fugalster/Wireless-HVAC-Sensors/board.png

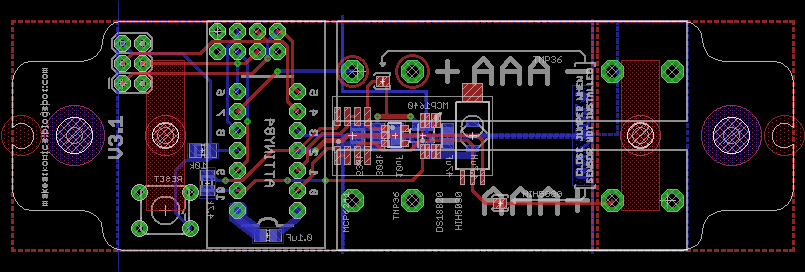
board.png
