fugalster/Wireless-HVAC-Sensors/schematic.png

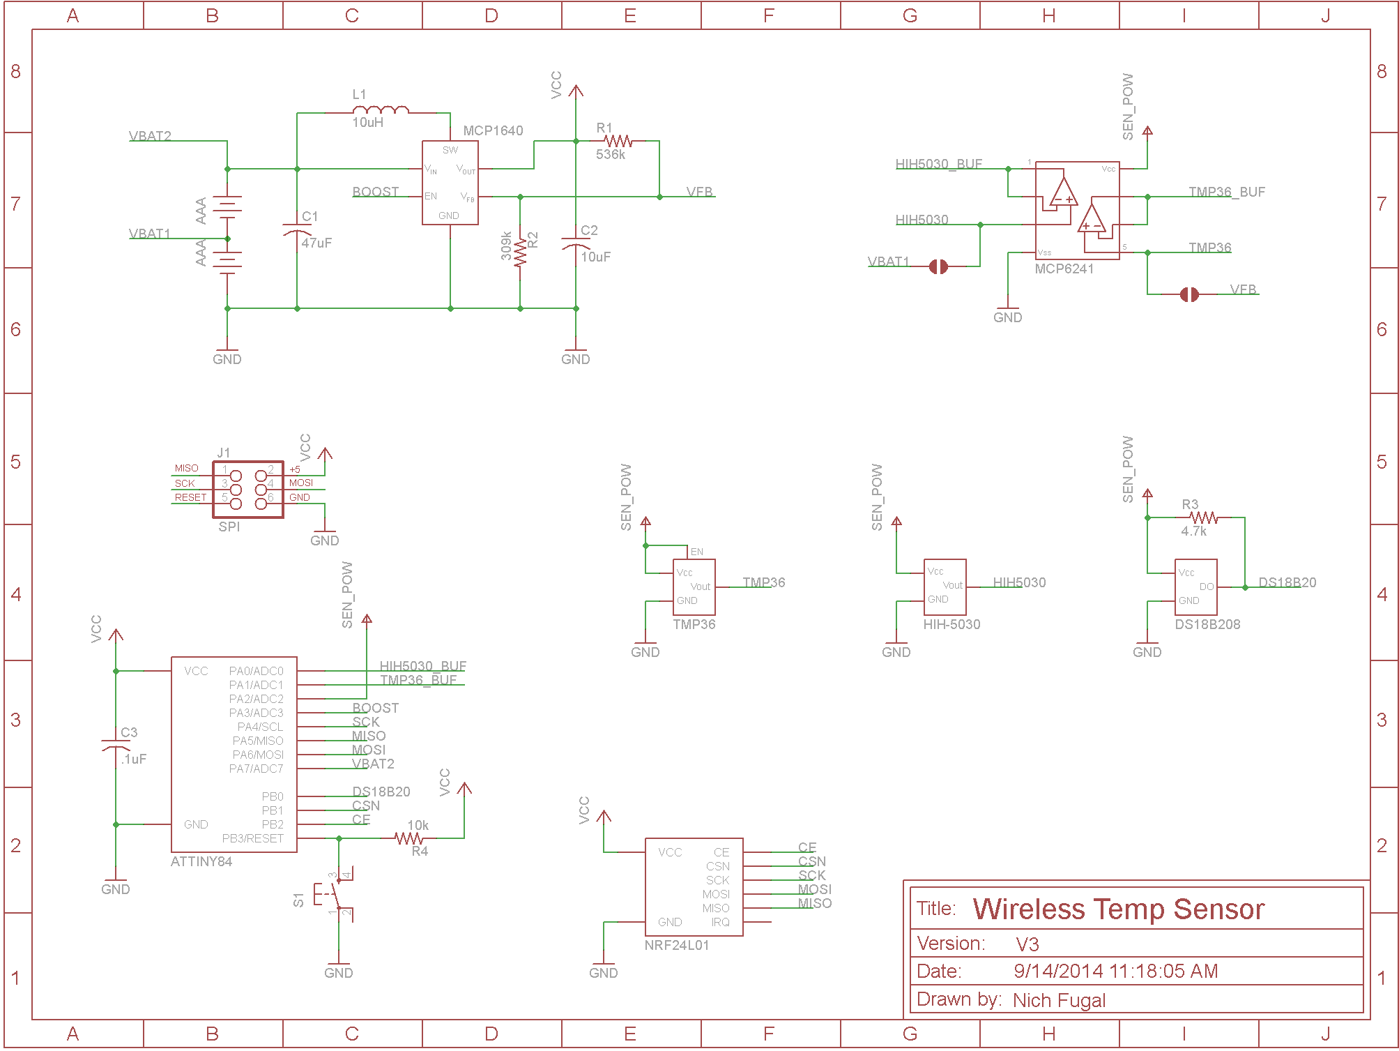
schematic.png
