fugalster/Wireless-HVAC-Sensors/Wireless Temp Sensor.brd

## EAGLE design Wireless Temp Sensor.brd (2014-09-23)

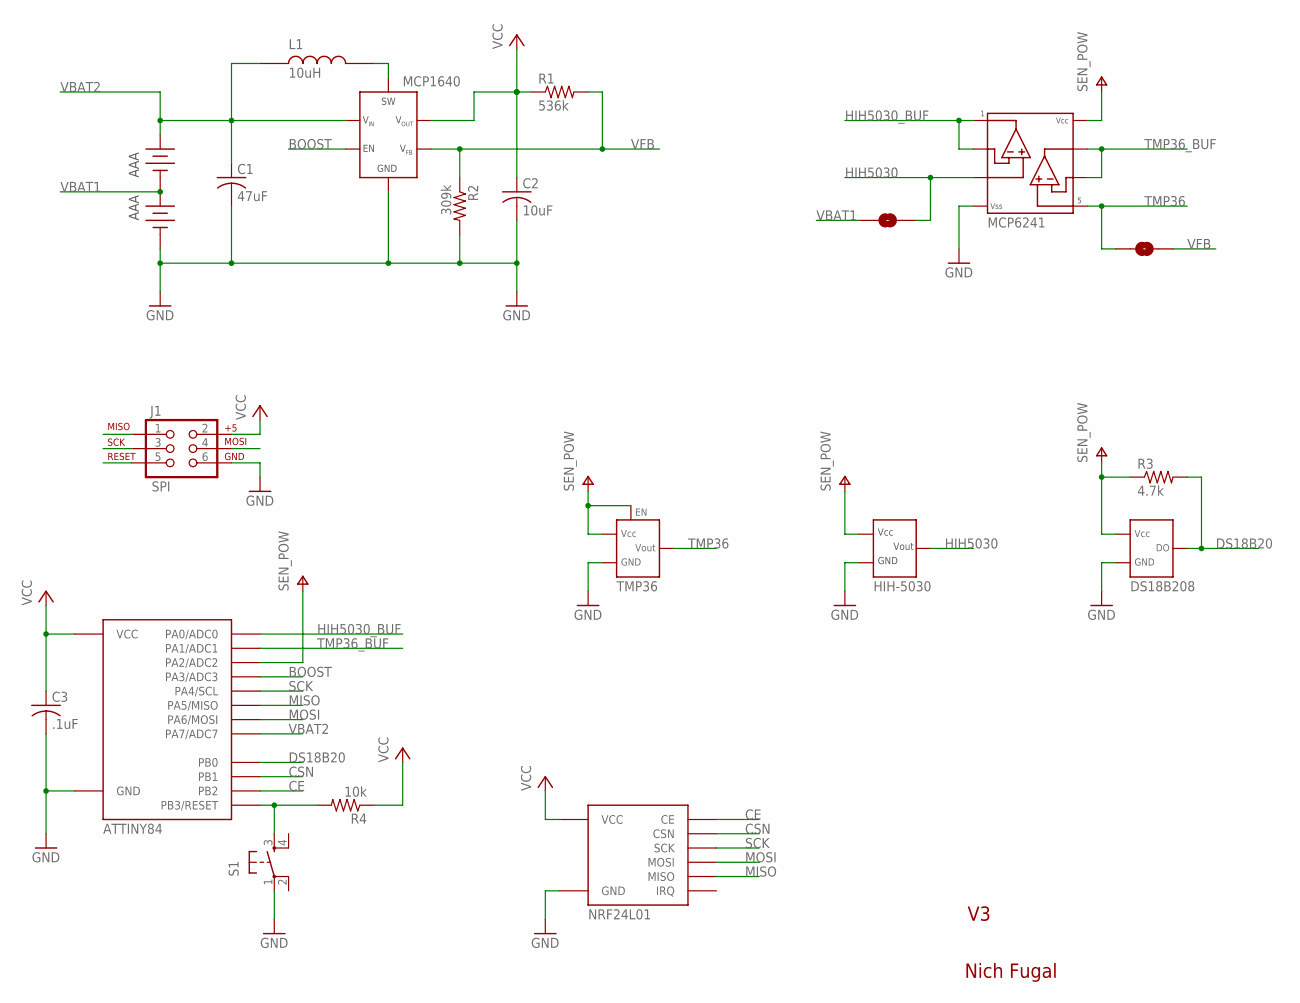
[picture p3: schematic Wireless Temp Sensor.sch]

Parts:
C1: 47uF; C0805
C2: 10uF; C0805
C3: .1uF; C0805
J1: SPI; 2X3
R1: 536k; M0805
R2: 309k; M0805
R3: 4.7k; M0805
R4: 10k; M0805
S1: TAC_SWITCHPTH; TACTILE-PTH
SJ1, SJ2: SOLDERJUMPER-OLDNO; SJ_2S-NO
U1: TMP36; SOT-23-5
U$1: MCP1640; SOT-23
U$2: 10uH; SD3114
U$3, U$8: AAA; BK-82_MPD
U$4: ATTINY84; 14-DIP
U$5: NRF24L01
U$6: DS18B208; 8-MSOP
U$7: HIH-5030
U$9: MCP6241; 8-SOIC

Connections:
BOOST: U$1.3 (EN), U$4.P$10 (PA3/ADC3)
CE: U$4.P$5 (PB2), U$5.P$3 (CE)
CSN: U$4.P$3 (PB1), U$5.P$4 (CSN)
DS18B20: R3.2, U$4.P$2 (PB0), U$6.P$1 (DO)
GND: C1.2, C2.2, C3.2, J1.6, R2.2, S1.1, U1.5 (GND), U$1.2 (GND), U$4.P$14 (GND), U$5.P$1 (GND), U$6.P$4 (GND), U$7.GND, U$8.P$3 (-), U$8.P$4 (-), U$9.P$4
HIH5030: SJ1.1, U$7.OUT, U$9.P$3
HIH5030_BUF: U$4.P$13 (PA0/ADC0), U$9.P$1, U$9.P$2
MISO: J1.1, U$4.P$8 (PA5/MISO), U$5.P$7 (MISO)
MOSI: J1.4, U$4.P$7 (PA6/MOSI), U$5.P$6 (MOSI)
unnamed: U$1.1 (SW), U$2.P$2
RESET: J1.5, R4.2, S1.3, U$4.P$4 (PB3/RESET)
SCK: J1.3, U$4.P$9 (PA4/SCL), U$5.P$5 (SCK)
SEN_POW: R3.1, U1.2 (VCC), U1.4 (EN), U$4.P$11 (PA2/ADC2), U$6.P$8 (VCC), U$7.VCC, U$9.P$8
TMP36: SJ2.1, U1.1 (VOUT), U$9.P$5
TMP36_BUF: U$4.P$12 (PA1/ADC1), U$9.P$6, U$9.P$7
VBAT1: SJ1.2, U$3.P$3 (-), U$3.P$4 (-), U$8.P$1 (+), U$8.P$2 (+)
VBAT2: C1.1, U$1.6 (VIN), U$2.P$1, U$3.P$1 (+), U$3.P$2 (+), U$4.P$6 (PA7/ADC7)
VCC: C2.1, C3.1, J1.2, R1.1, R4.1, U$1.5 (VOUT), U$4.P$1 (VCC), U$5.P$2 (VCC)
VFB: R1.2, R2.1, SJ2.2, U$1.4 (VFB)

Notes on the sheet:
AAA
10uH
Nich Fugal

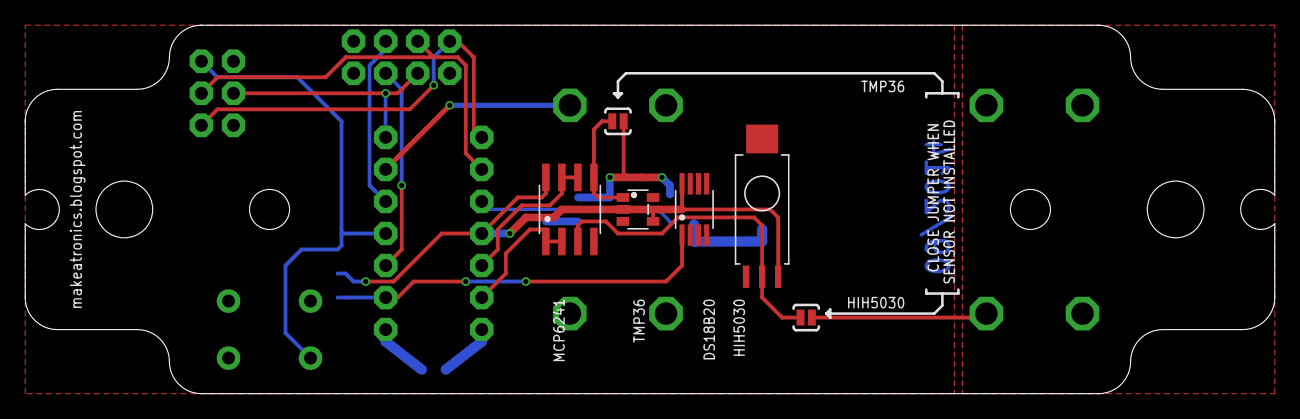
[picture p4: board Wireless Temp Sensor.brd from above]

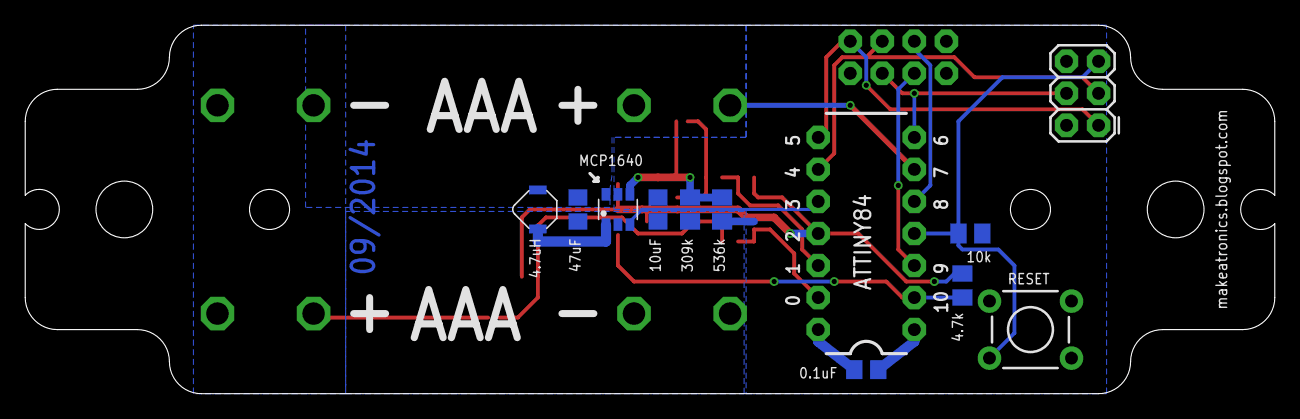
[picture p5: board Wireless Temp Sensor.brd from below]

Board: 2 copper layers, 99.1 x 29.2 mm, 21 parts (15 on the bottom side), 19 nets.
