fugalster/Wireless-HVAC-Sensors/(commit log)

2014-09-14 Added design files
    [BOM.csv, Wireless Temp Sensor.brd, Wireless Temp Sensor.sch]
2014-09-23 V3.1
    Minor modifications to copper fill and battery terminal spacing.
    [Wireless Temp Sensor.brd]
2014-09-23 Updated board image to V3.1
